Guimi22/DSP-Audio-Amplifier/Defensa/TFG_GuillemRoperoSerrano.pdf

# Disseny i implementació d’un

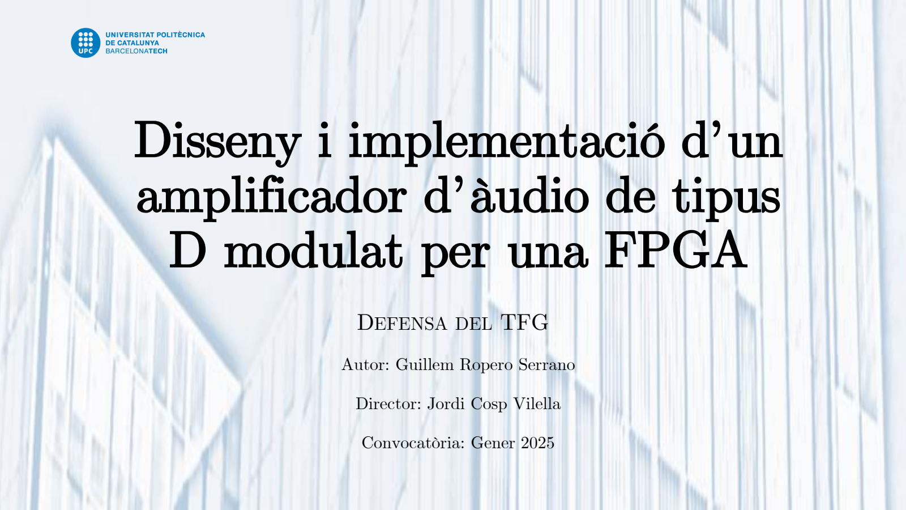
[picture p1: page 1]

# amplificador d’àudio de tipus D modulat per una FPGA

DEFENSA DEL TFG

Director: Jordi Cosp Vilella

Autor: Guillem Ropero Serrano

Convocatòria: Gener 2025

# Introducció

Fig. 1.- Diagrama de blocs d’un amplificador digital de classe D.

# Introducció

Eff. Energ.

≈ 90-80 %

TAS2320 | 93,2 – 80 %
MAX98365 | 92,7 – 84,8 %

Taula 1.- Taula de rendiment energètics d’amplificadors d’àudio de tipus D comercials.

# Introducció

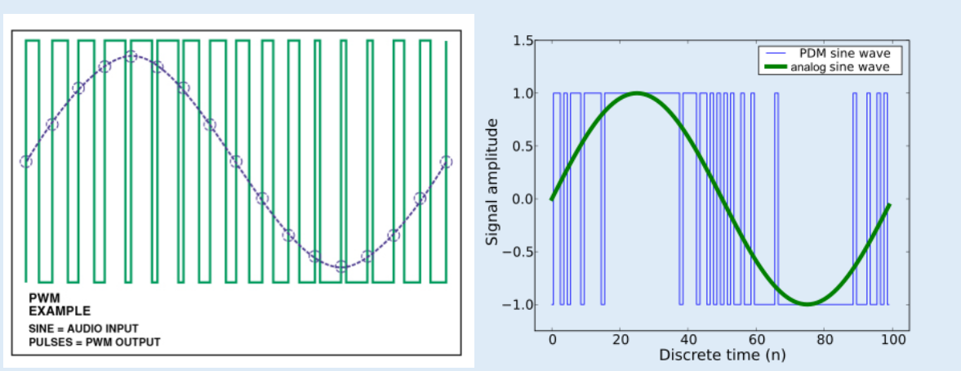
[picture p2: figure]

Fig. 2.- Estratègies de modulació: PWM (dreta) [1], PDM (esquerra) [2].

# Introducció

Fig. 1.- Diagrama de blocs d’un amplificador digital de classe D.

# TFG

# Introducció

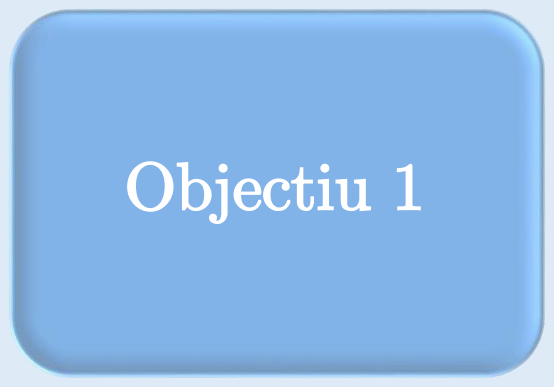
[picture p3: figure]

## Implementar Receptor I2S

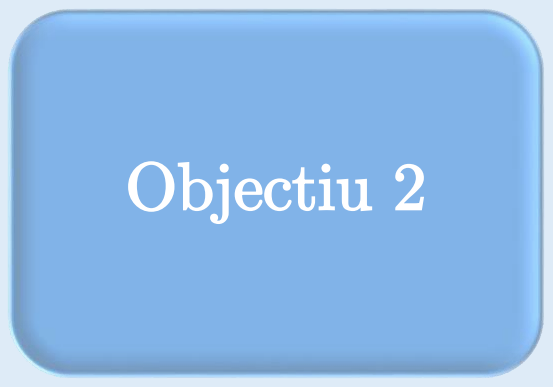
[picture p4: figure]

## D & I Filtre Anti-Aliasing

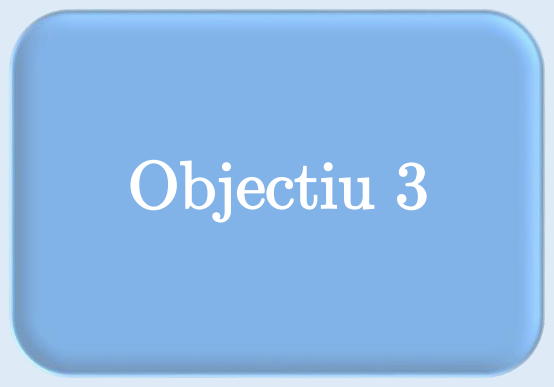
[picture p5: figure]

D & I

## modulador ΣΔ

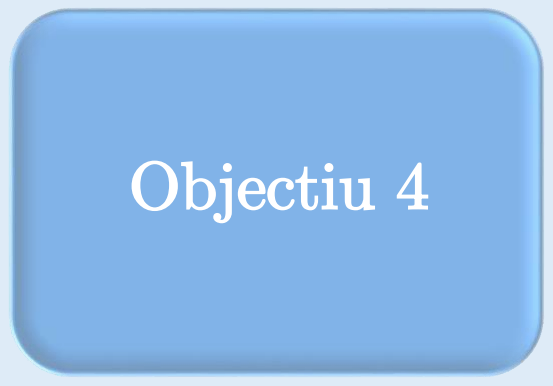
[picture p6: figure]

## D & I Filtre Delmat

Objectiu 1 | Objectiu 2 | Objectiu 3 | Objectiu 4

# Proposta de Resolució

# Diagrama de blocs del sistema

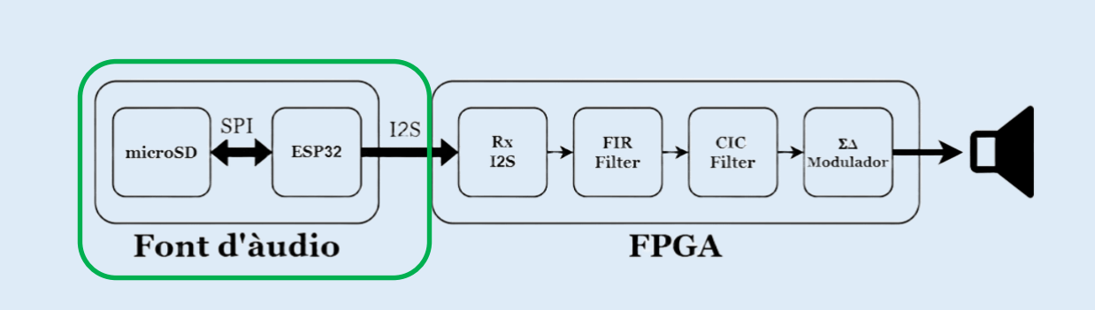
[picture p7: figure]

Fig. 2.- Diagrama de blocs del sistema implementat.

# Font d’Àudio Digital

# Font d’Àudio Digital

# Objectius:

## - Lectura d’arxius .wav - Transmetre mostres d’àudio en protocol I2S - Freqüència de mostreig = 44,1 kHz - Format Philips estàndard

# Font d’Àudio Digital

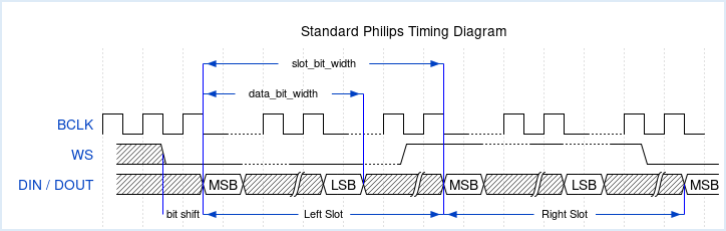
[picture p8: figure]

Fig. 3.- Frame del bus I2S en mode d’operació de l’estàndard Philips. [3]

# Font d’Àudio Digital

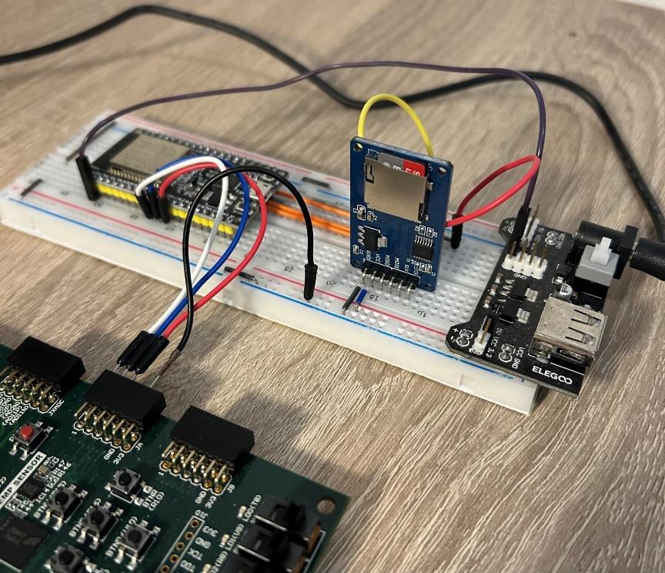
[picture p9: figure]

Fig. 3.- Fotografía de la implementació de la font d’àudio.

# Font d’Àudio Digital

## Què s’ha utilitzat? - Targeta ESP32

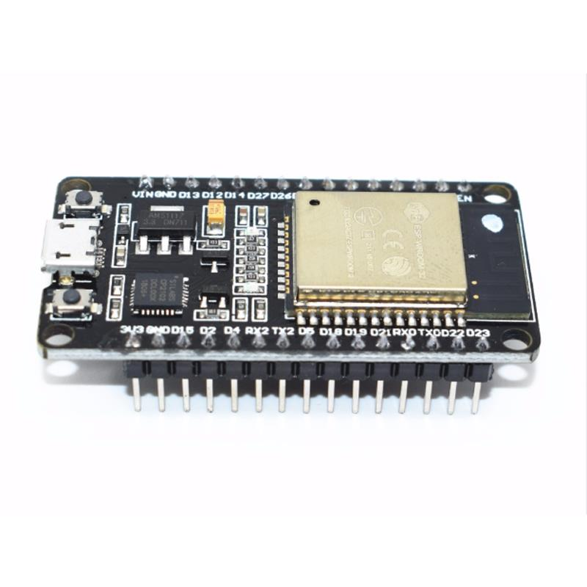
[picture p10: figure]

Fig. 4.- Fotografía d’una
targeta ESP32 WROOM.
[4]

# Font d’Àudio Digital

## Què s’ha utilitzat? - Mòdul adaptador targeta microSD

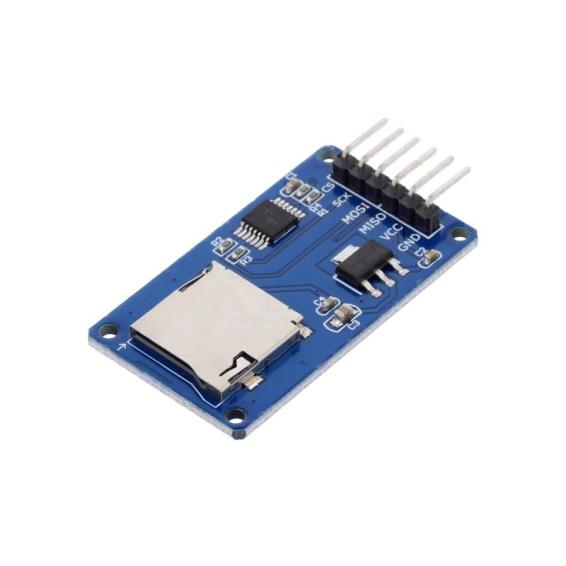
[picture p11: figure]

Fig. 5.- Fotografía del
mòdul adaptador d’una
targeta microSD. [4]

# Font d’Àudio Digital

## Què s’ha utilitzat? - Targeta microSD

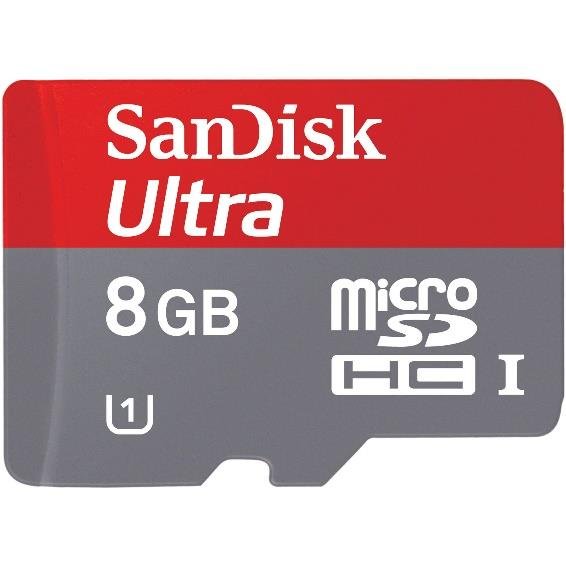
[picture p12: figure]

Fig. 6.- Fotografía de
la targeta microSD
utilitzada per
emmagatzemar
l’arxiu .wav . [5]

# Font d’Àudio Digital

## Què s’ha utilitzat? - Mòdul alimentació 5V i

3,3V

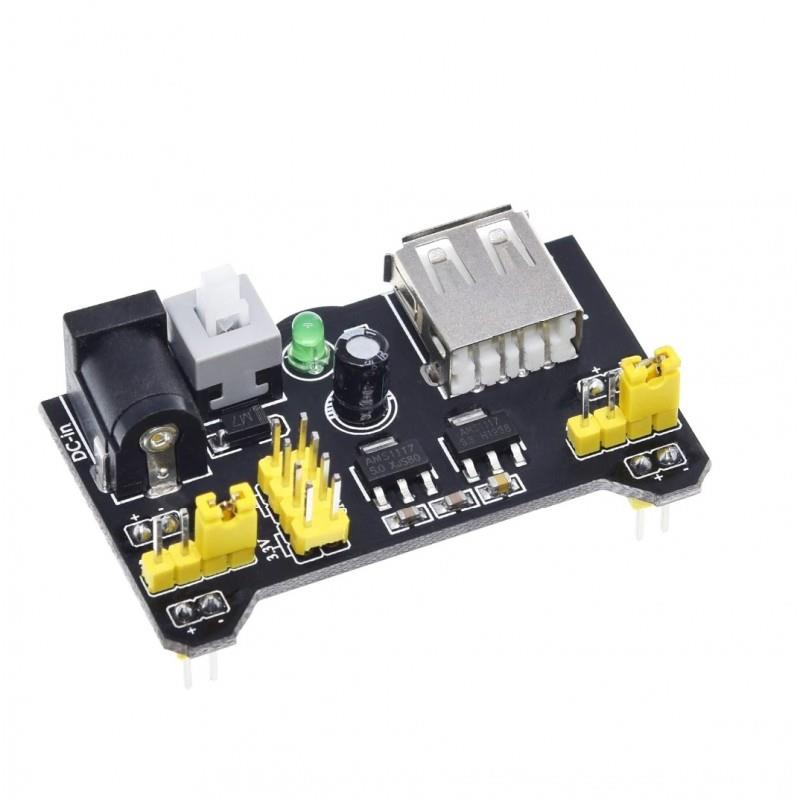
[picture p13: figure]

Fig. 7.- Fotografía d’un
mòdul d’alimentació 5V
i de 3,3V. [4]

# Font d’Àudio Digital

# Funcionalitats del codi

## - Lectura de l’arxiu emmagatzemat a la targeta microSD - Transmetre les mostres d’àudio pel bus I2S

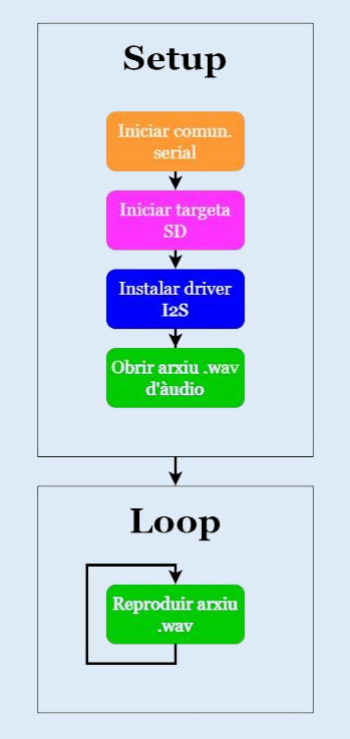
[picture p14: figure]

Fig. 8.- Diagrama de flux
del codi implementat pel
funcionament de la font
d’àudio.

# Diagrama de blocs del sistema

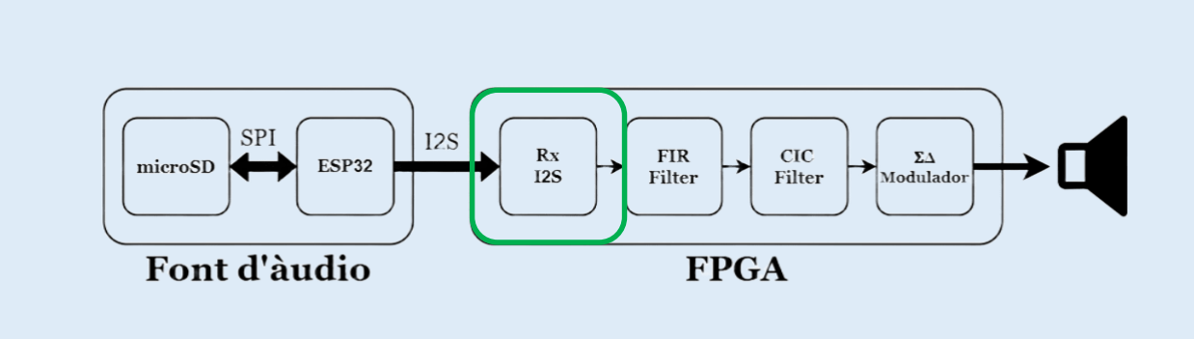
[picture p15: figure]

Fig. 2.- Diagrama de blocs del sistema implementat.

# Receptor I2S

# Receptor I2S

# Objectius:

## - Lectura bus I2S en format Philips estàndard - Capturar mostres d’àudio enviades pel bus I2S - Amplada mostres d’àudio de 16 bits - Sortida àudio mono

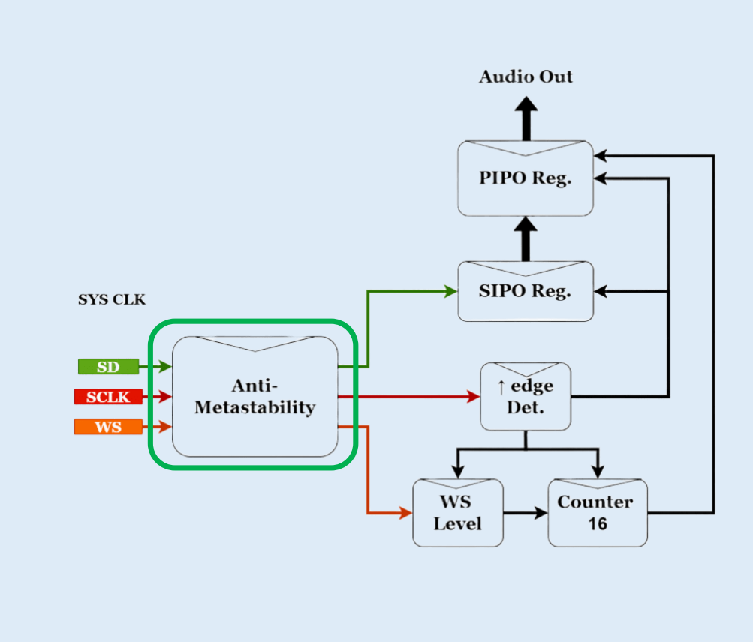
[picture p16: figure]

Fig. 9.

- Diagrama de
blocs de l’entitat
dissenyada en VHDL.

# Receptor I2S

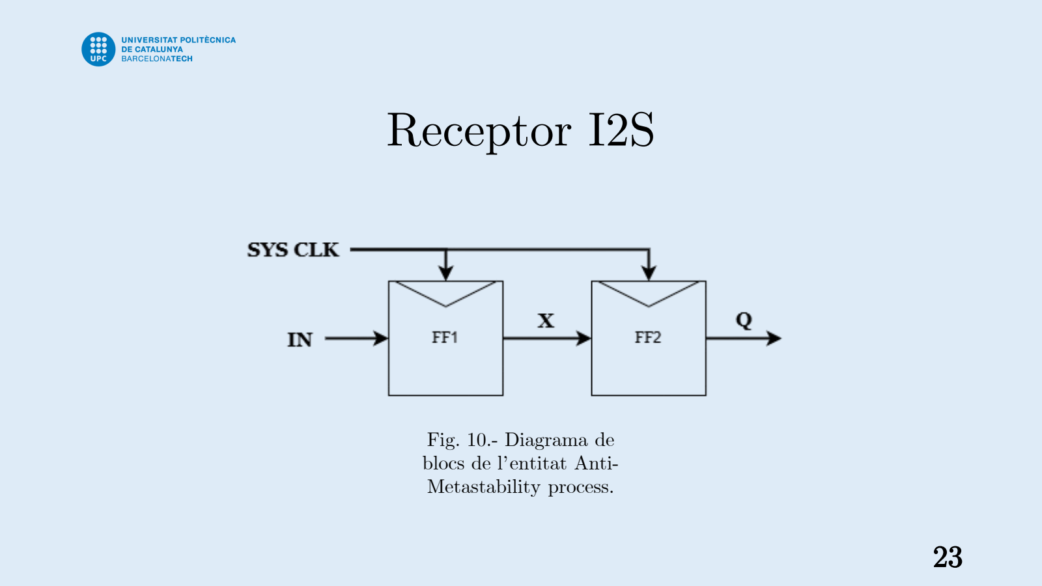
[picture p17: page 23]

Fig. 10.- Diagrama de
blocs de l’entitat Anti-Metastability process.

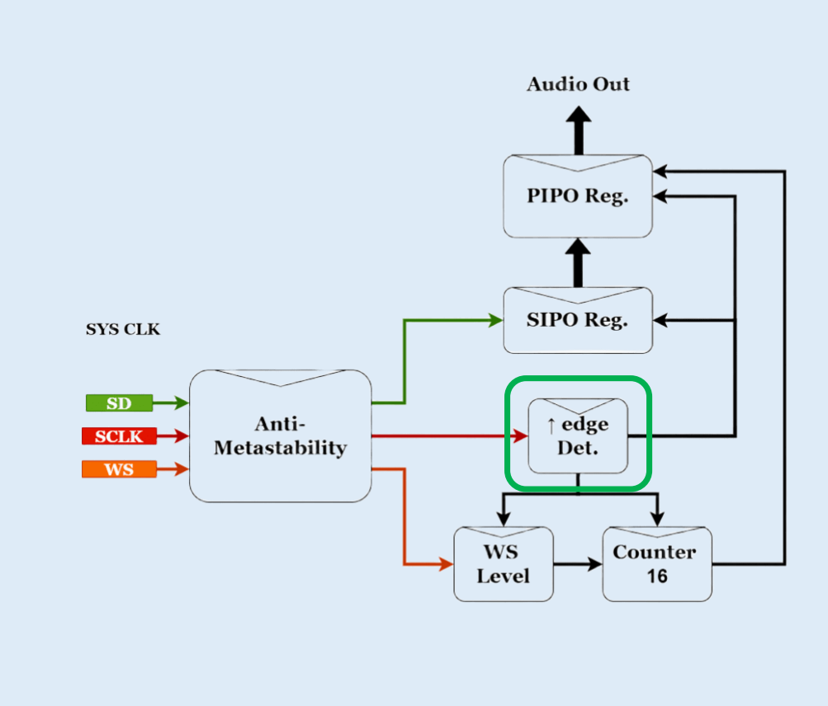
[picture p18: figure]

Fig. 9.

- Diagrama de
blocs de l’entitat
dissenyada en VHDL.

# Receptor I2S

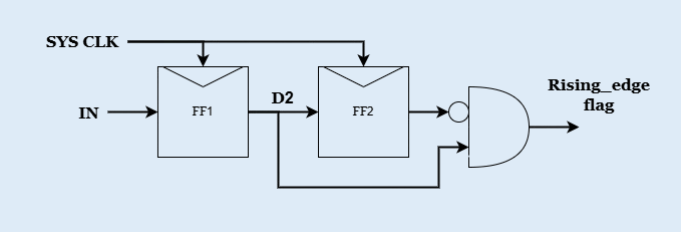
[picture p19: figure]

Fig. 11.- Diagrama de blocs de l’entitat Rising edge Detection.

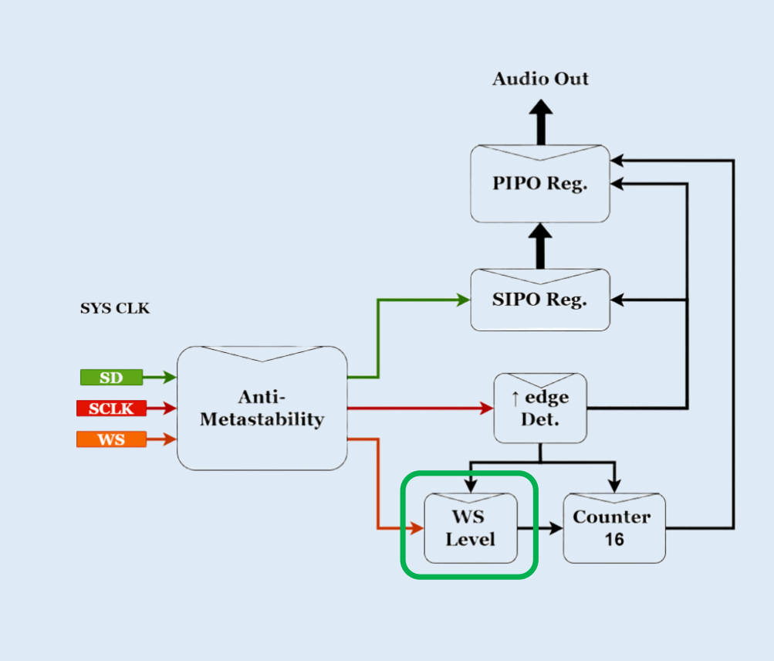
[picture p20: figure]

Fig. 9.

- Diagrama de
blocs de l’entitat
dissenyada en VHDL.

# Receptor I2S

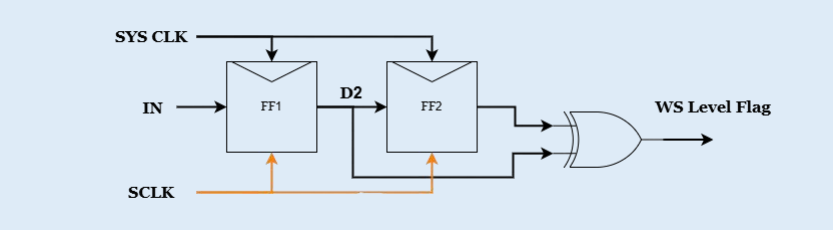
[picture p21: figure]

Fig. 12.- Diagrama de blocs de l’entitat WS Level Detection.

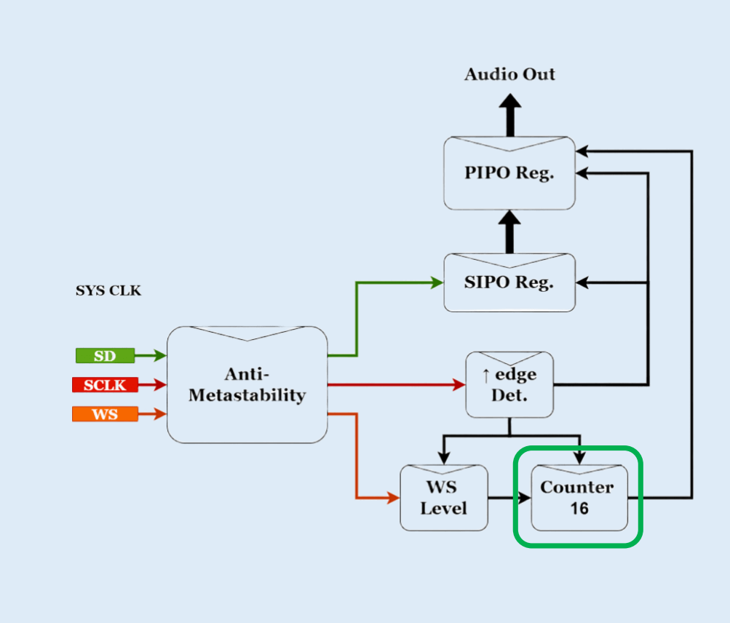
[picture p22: figure]

Fig. 9.

- Diagrama de
blocs de l’entitat
dissenyada en VHDL.

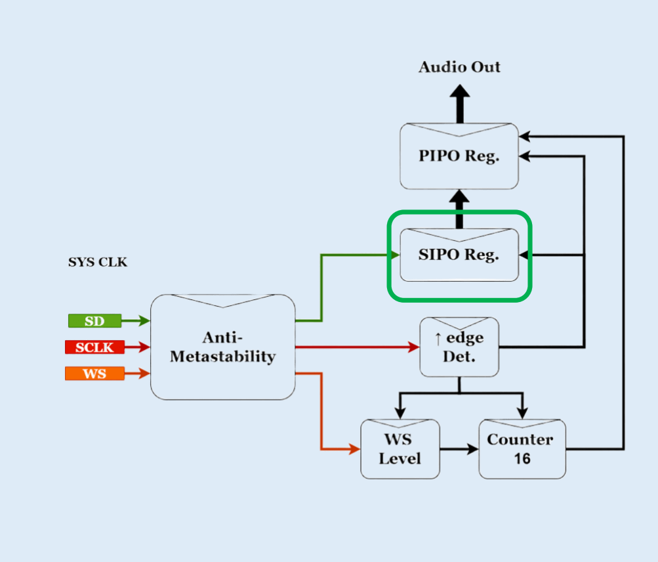
[picture p23: figure]

Fig. 9.

- Diagrama de
blocs de l’entitat
dissenyada en VHDL.

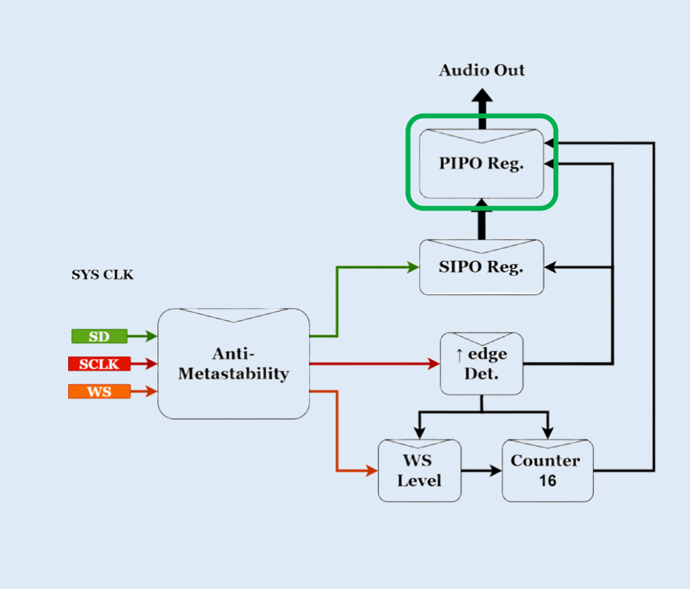
[picture p24: figure]

Fig. 9.

- Diagrama de
blocs de l’entitat
dissenyada en VHDL.

# Diagrama de blocs del sistema

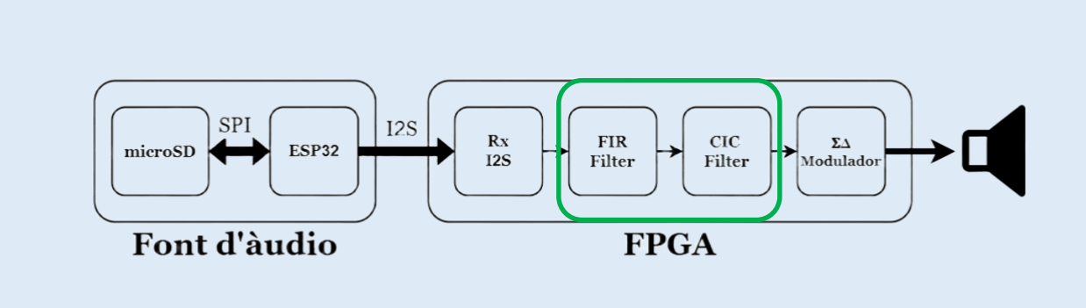
[picture p25: figure]

Fig. 2.- Diagrama de blocs del sistema implementat.

# Filtre Anti-Aliasing

# Filtre Anti-Aliasing

# Objectius:

## - Sobremostrejar el senyal d’entrada a x32 de la freqüència de mostreig i

interpolar.

## - Atenuar components harmònics fora de l’espectre

d’interés (20 a 20000 Hz).

# Filtre Anti-Aliasing

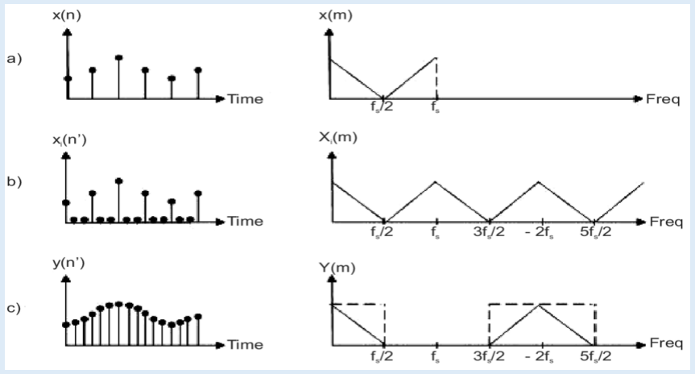
[picture p26: figure]

Fig. 13.- Procés d’interpolació d’un senyal en temps discret. [6]

# Filtre Anti-Aliasing

## L’etapa de filtrat es divideix en dues etapes: - Filtre de compensació - Filtre CIC

# Filtre Anti-Aliasing

## Filtre de compensació

Factor d’interpolació | 2
Freqüència de pas | 20 kHz
Freqüència de tall | 22,05 kHz
Atenuació a la banda de tall | 80 dB
Freqüència de mostreig | 44,1 kHz

Taula 2.- Especificacions del filtre de compensació de l’etapa d’Interpolació.

# Filtre Anti-Aliasing

## Filtre de compensació

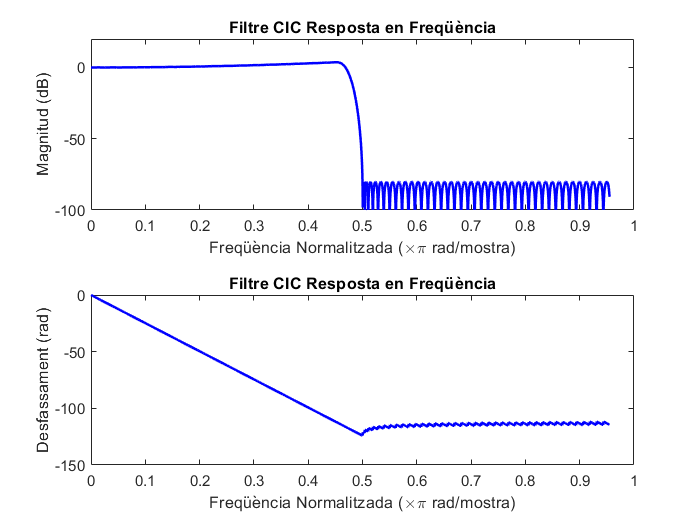
[picture p27: figure]

Fig. 14.- Diagrama de
Bode de l’etapa de filtrat i compensació de la resposta en freqüència de
l’interpolador CIC.

# Filtre Anti-Aliasing

## Filtre de compensació Implementació a la FPGA: - Mòdul IP FIR Compiler

Nom del Paràmetre | Valor
Tipus de Filtre | Interpolació
Taxa d’Interpolació | 2
Freqüència de mostreig d’entrada | 44,1 kHz
Freqüència del rellotge | 100 MHz
Tipus de coeficients | Amb signe
Amplada de coeficients | 153
Tipus de dades d’entrada | Amb signe
Amplada de les dades d’entrada | 16
Mode d’arrodoniment a la sortida | Truncar els LSBs
Amplada de dades a la sortida | 16

Taula 3.- Configuracions dels paràmetres del mòdul IP FIR Compiler.

# Filtre Anti-Aliasing

## Filtre CIC

y | n | =

σk=0

## M−1 x[n − k]

M

y | n | =
y | n − 1 | + x | n | − x[n − M]
| | | M

Filtre de Mitjana Mòbil:

Filtre CIC:

# Filtre Anti-Aliasing

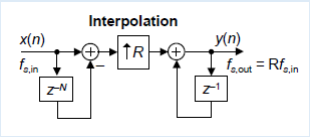
[picture p28: figure]

Fig. 15.- Estructura d’un filtre CIC Interpolador. [7]

## Filtre CIC

# Filtre Anti-Aliasing

Factor d’interpolació (R) | 16
Delay diferencial (M) | 1
Ordre del filtre (N) | 5

Taula 4.- Especificacions del filtre CIC.

## Filtre CIC

# Filtre Anti-Aliasing

## Filtre CIC

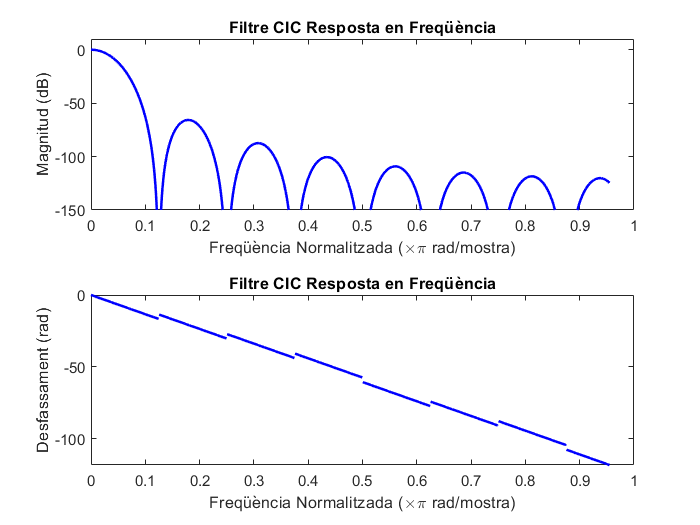
[picture p29: figure]

Fig. 16.- Diagrama de
Bode de l’etapa de
l’interpolador CIC.

# Filtre Anti-Aliasing

## Filtre CIC Implementació a la FPGA: - Mòdul IP CIC Compiler

Nom del Paràmetre | Valor
Tipus de Filtre | Interpolació
Taxa d’Interpolació | 16
Freqüència de mostreig d’entrada | 88,2 kHz
Freqüència del rellotge | 100 MHz
Amplada de les dades d’entrada | 16
Quantificació | Truncament
Amplada de dades a la sortida | 16

Taula 5.- Configuracions dels paràmetres del mòdul IP CIC Compiler.

# Filtre Anti-Aliasing

## Resultats Etapa de filtrat

Taula 6.- Especificacions de l’etapa de filtrat anti-aliasing.

Oscil·lació máxima en la banda de pas | 1,49 dB
Freqüència de tall | 20460 Hz
Atenuació en la banda de tall | -53 dB

# Filtre Anti-Aliasing

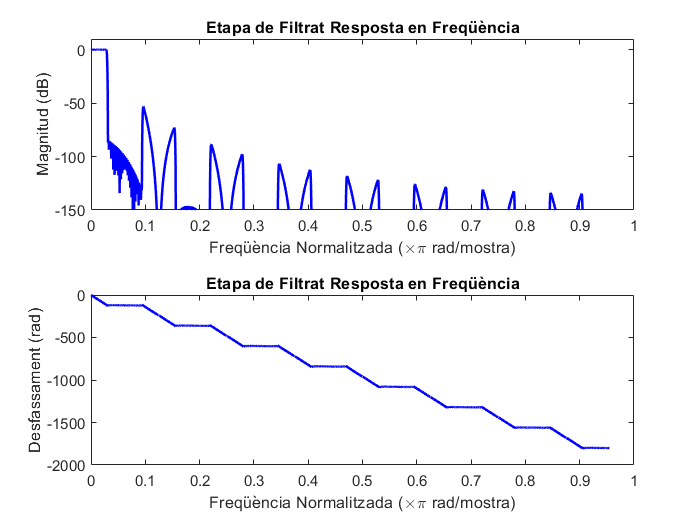
[picture p30: figure]
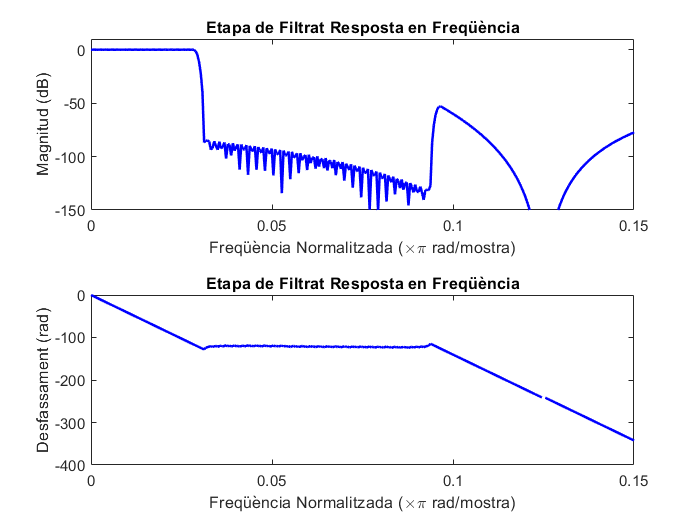
[picture p31: figure]

Fig. 17.- Diagrama de Bode de l’etapa de filtrat anti-aliasing.

## Resultats Etapa de filtrat

# Diagrama de blocs del sistema

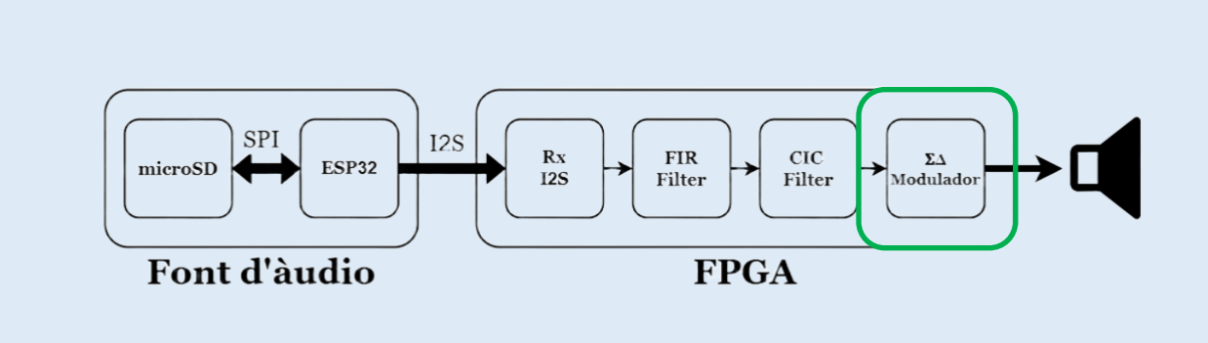
[picture p32: figure]

Fig. 2.- Diagrama de blocs del sistema implementat.

# Modulador ΣΔ

# Modulador ΣΔ

# Objectius:

## - Desplaçar soroll produit pel procés de quantificació a freqüències > freqüència de

mostreig.

## - Atenuar components harmònics del senyal fora de

la banda de mostreig.

# Modulador ΣΔ

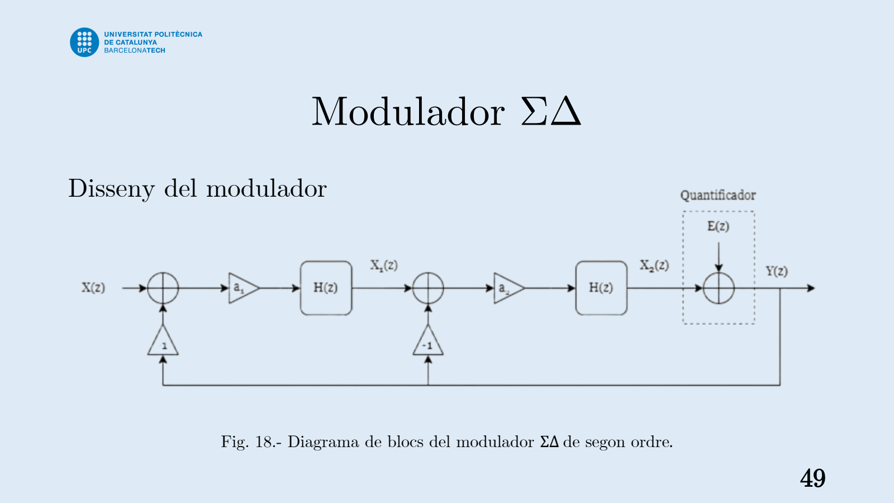
[picture p33: page 49]

## Disseny del modulador

Fig. 18.- Diagrama de blocs del modulador ΣΔ de segon ordre.

# Modulador ΣΔ

## Disseny del modulador

a1 = a2 = 0,5 H z =

z

−1
1 − z

−1

STF z =

z

−2
3z

−2 − 6z

−1 + 4

NTF z =

(1 − z

−1
)

2
3z

−2 − 6z

−1 + 4

# Modulador ΣΔ

## Disseny del modulador

Fig. 19.- Cercle unitari en el pla polar de STF i

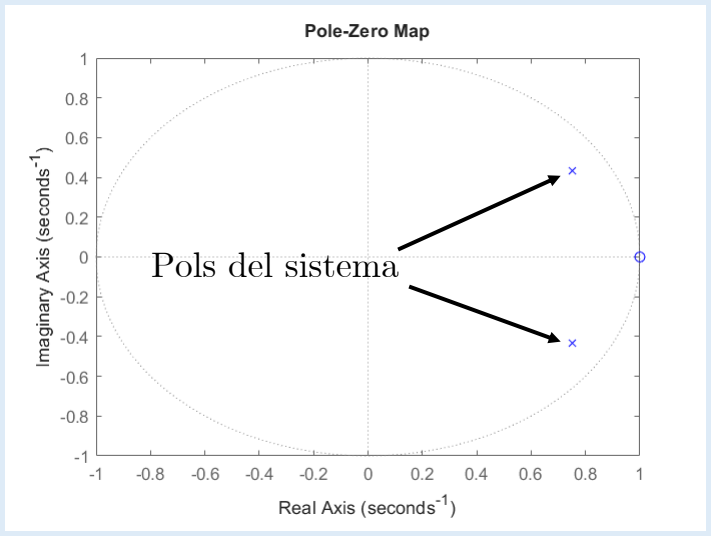
[picture p34: figure]

NTF. | Pols del sistema

# Modulador ΣΔ

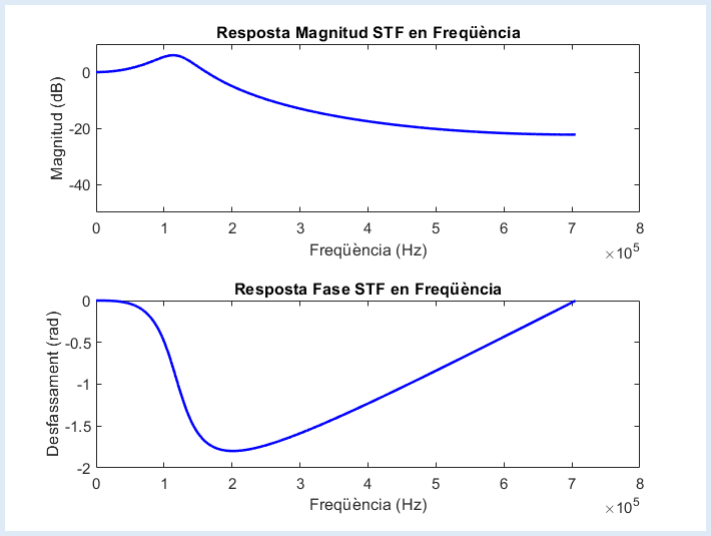
[picture p35: figure]

## Disseny del modulador

Fig. 20.- Diagrama de
Bode de la funció de
transferència del senyal
(STF).

# Modulador ΣΔ

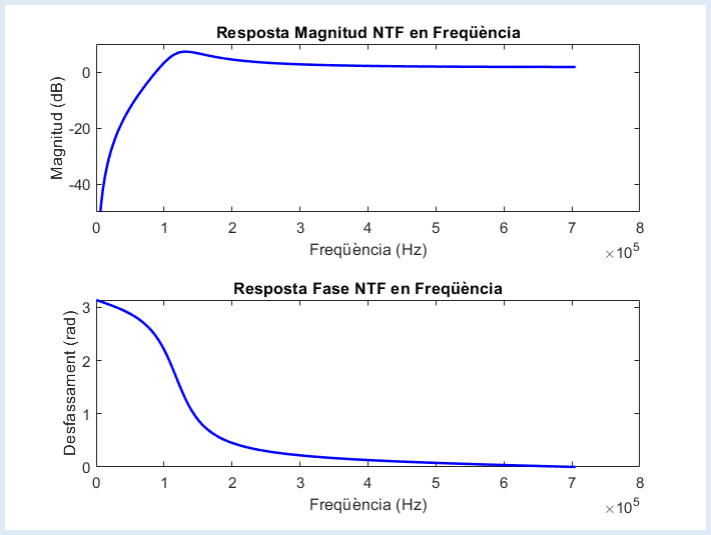
[picture p36: figure]

## Disseny del modulador

Fig. 21.- Diagrama de
Bode de la funció de
transferència del soroll
(NTF).

# Modulador ΣΔ

## Disseny del modulador

SQNR | 70,1 dB
DR | 112,28 dB
OSR | 32
Freqüència de mostreig | 1,41 MHz
Freqüència de tall de la STF | 183,6 kHz
Freqüència de tall de la NTF | 77,95 kHz
Freqüència de pic de la STF i NTF | 117,46 kHz

Taula 7.- Taula de les
mètriques de rendiment
calculades pel modulador
ΣΔ.

# Modulador ΣΔ

## Implementació a la FPGA

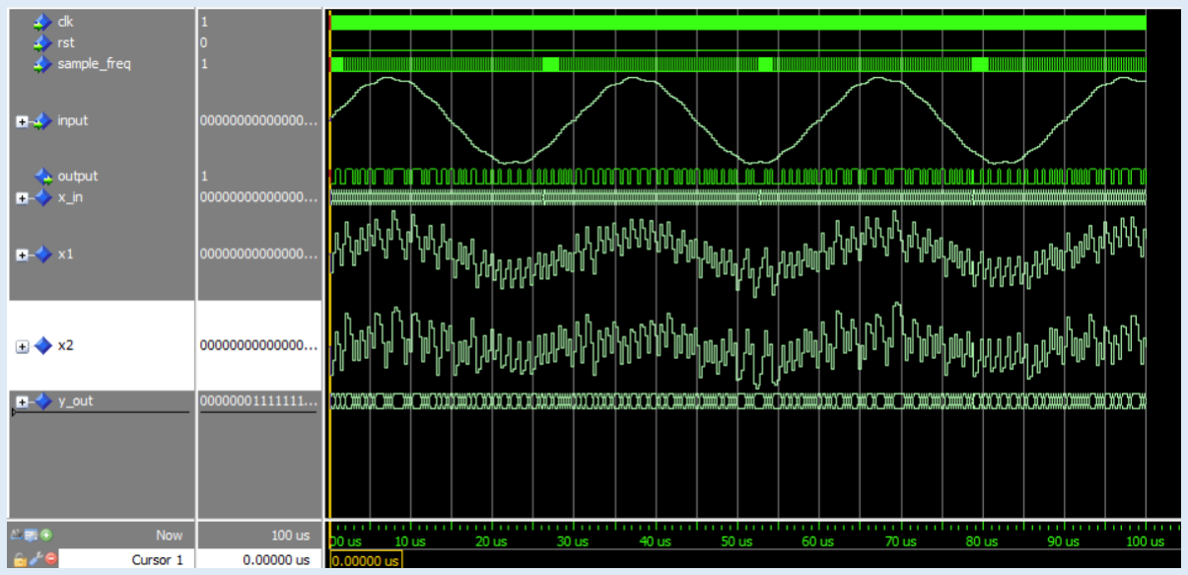
[picture p37: figure]

Fig. 22.- Cronograma del
banc de proves del
modulador ΣΔ.

# Modulador ΣΔ

## Implementació a la FPGA

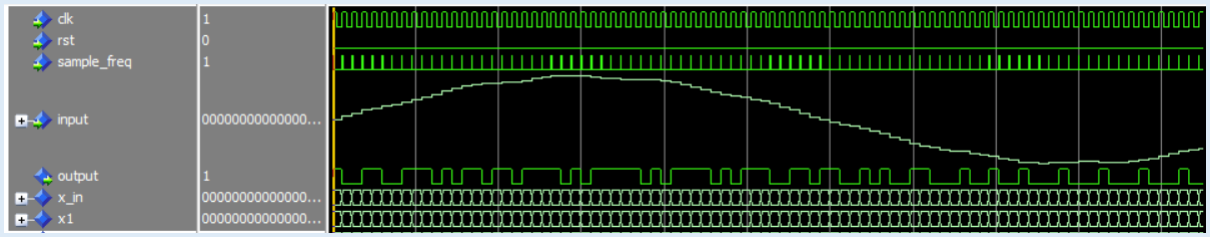
[picture p38: figure]

Fig. 23.- Cronograma del banc de proves del modulador ΣΔ.

# Implementació final

Recurs | Nombre
LUTs | 1170
Registres | 891
Slices | 247
Muxes | 46
DSPs | 4

# Implementació final

Taula 8.- Utilització
de recursos de la
FPGA en la
implementació final
del projecte.

# Projecte sintetitzat a la FPGA

# Implementació final

# Resultat final

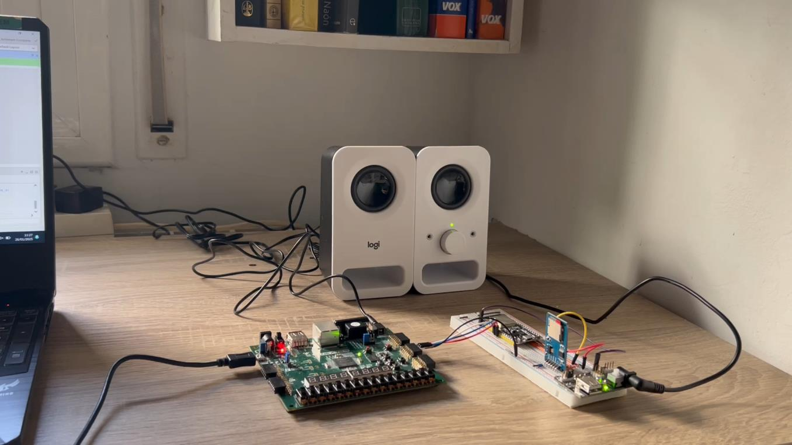
[picture p39: figure]

# Implementació final

# Conclusions

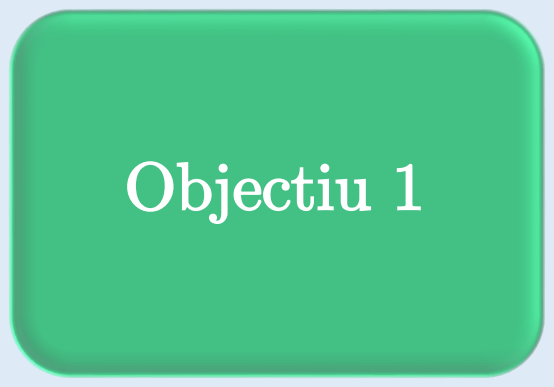
[picture p40: figure]

## Implementar Receptor I2S

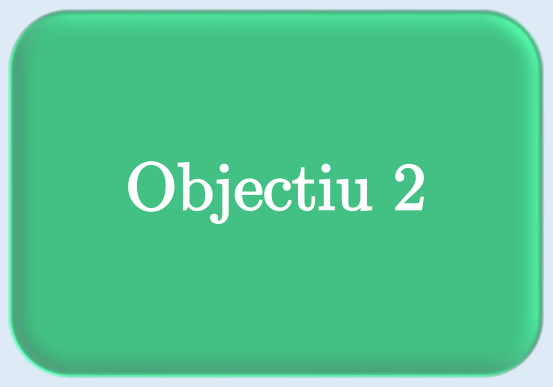
[picture p41: figure]

## D & I Filtre Anti-Aliasing

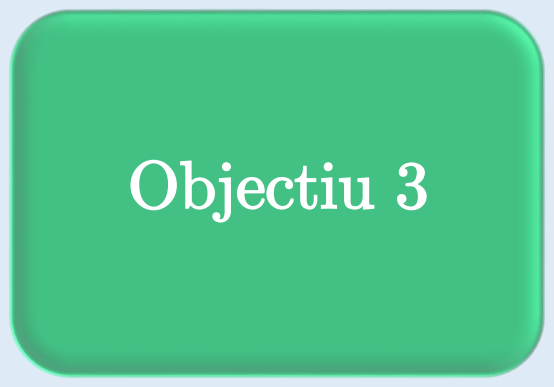
[picture p42: figure]

D & I

## modulador ΣΔ

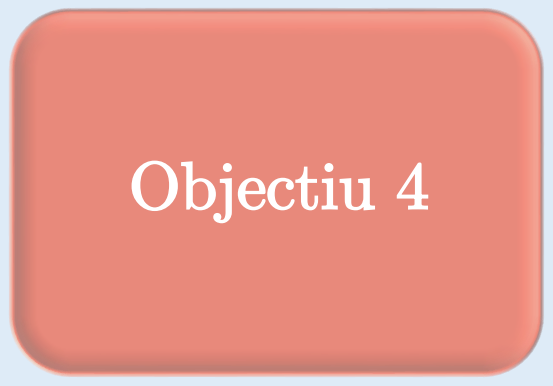
[picture p43: figure]

## D & I Filtre Delmat

Objectiu 1 | Objectiu 2 | Objectiu 3 | Objectiu 4

# Implementació final

- Disseny & Implementació d’una etapa de delmat.
- Disseny d’un modulador ΣΔ de major ordre.

## - Disseny & Implementació d’una etapa d’amplificació amb

transistors GaN FET.

# Futures línies de treball

# Bibliografía

[1] E. Gaalaas,

“Class D Audio amplifiers: What, why, and how”, Analog Devices. https://www.analog.com/en/resources/analog-dialogue/articles/class-d-audio-amplifiers.html

[2] Wikipedia contributors, “Pulse-density modulation”, Wikipedia, Feb. 14, 2024. https://en.wikipedia.org/wiki/Pulse-density_modulation
[3] E. Systems, “Inter-ic sound (i2s)- esp32- esp-idf programming guide v5.4 documentation.” https://docs.espressif.com/projects/esp-idf/en/stable/esp32/api-reference/peripherals-/i2s.html, accedit el Gener 2025.
[4] Diotronic, “Diotronic S.A. – Componentes electrònicos” https://diotronic.com/, accedit el Gener 2025.

# Bibliografía

[5] eBay, “8G SanDisk Micro SD TF Memory Card 8GB Flash Memory Card Mini SDHC SDXC Adapter” https://www.ebay.ca/itm/8G-SanDisk-Micro-SD-TF-Memory-Card-8GB-Flash-Memory-Card-Mini-SDHC-SDXC-Adapter/224081107877, accedit el Gener 2025.
[6] F. Rubén, I. A. Badillo, G. F. Torres, and J. S. García, “Simplification to the fast FIR-FFT filtering technique in the DSP interpolation process for band-limited signals” Revista Facultad de Ingeniería Universidad de Antioquia, no. 68, pp. 9–19, Oct. 2013, doi: https://doi.org/10.17533/udea.redin.17036.
[7] R. Lyons, “A beginner’s guide to cascaded integrator-comb (cic) filters.” https: //www.dsprelated.com/showarticle/1337.php, accedit el Gener 2025.

# Gràcies per la vostra atenció
