Guimi22/DSP-Audio-Amplifier/Defensa/Imatges/codi_counter2.png

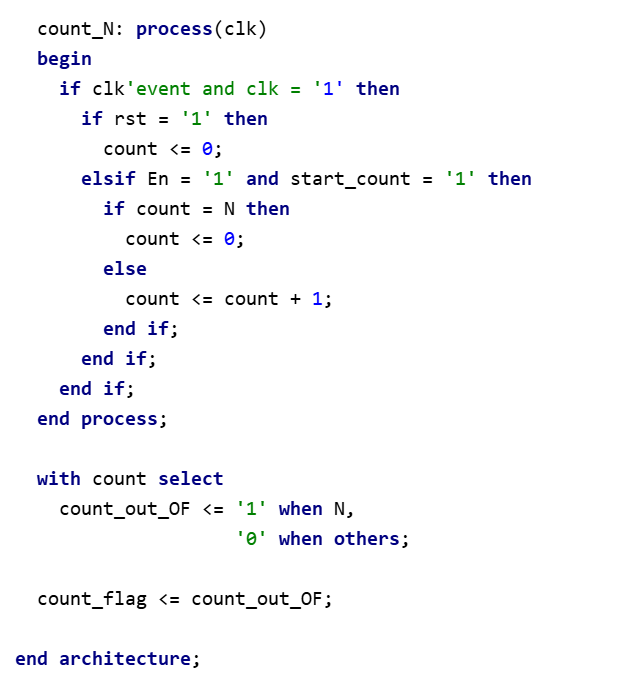
Defensa/Imatges/codi_counter2.png
