Guimi22/DSP-Audio-Amplifier/Defensa/Imatges/codi_counter.png

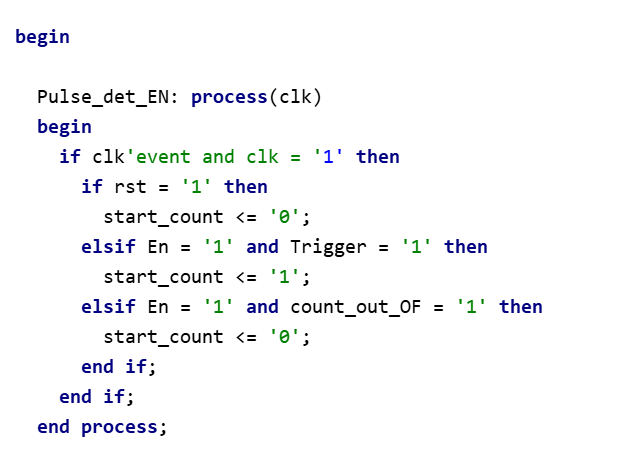
Defensa/Imatges/codi_counter.png
