Guimi22/DSP-Audio-Amplifier/Defensa/Imatges/codi_filtrecompCIC.png

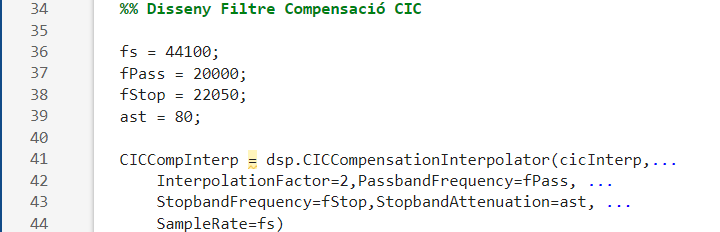
Defensa/Imatges/codi_filtrecompCIC.png
