Guimi22/DSP-Audio-Amplifier/Defensa/Imatges/codi_PIPO.png

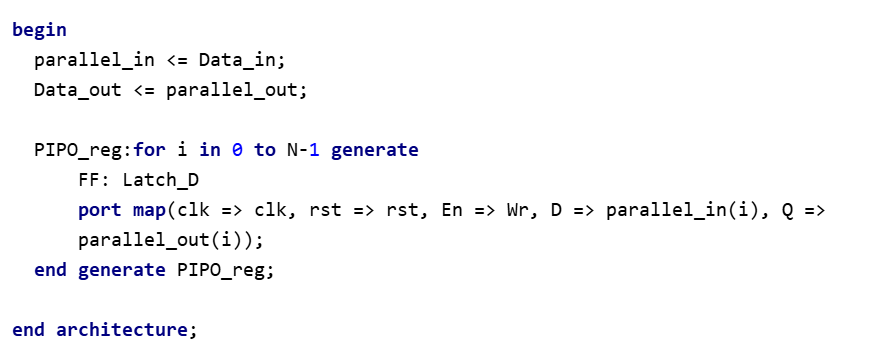
Defensa/Imatges/codi_PIPO.png
