Guimi22/DSP-Audio-Amplifier/Defensa/Imatges/codi_Risng_edge_det.png

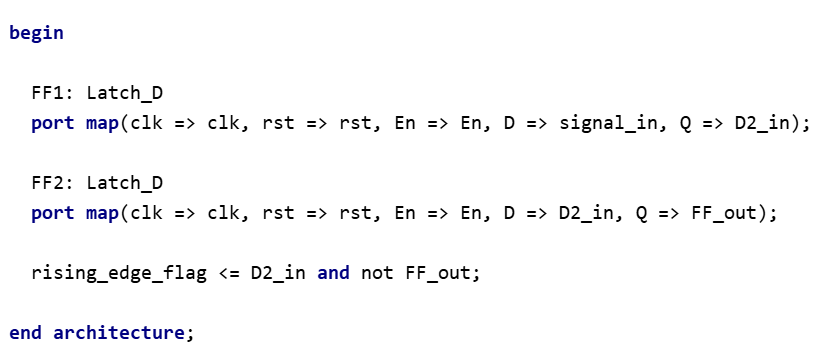
Defensa/Imatges/codi_Risng_edge_det.png
