Guimi22/DSP-Audio-Amplifier/Defensa/Imatges/codi_SD.png

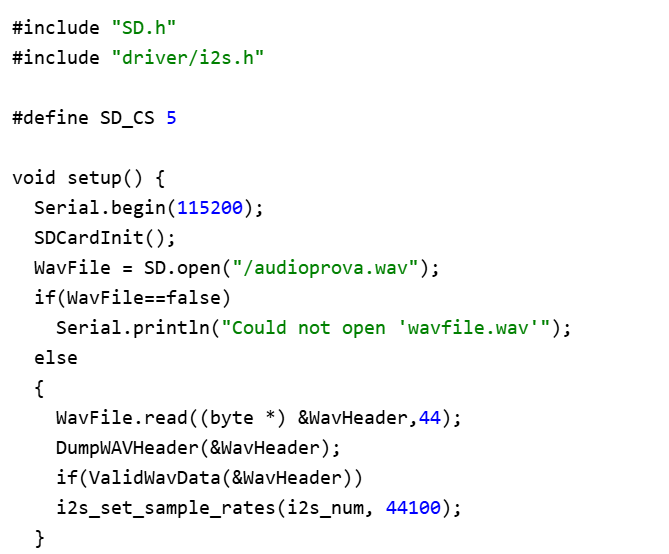
Defensa/Imatges/codi_SD.png
