Guimi22/DSP-Audio-Amplifier/Defensa/Imatges/codi_SIPO.png

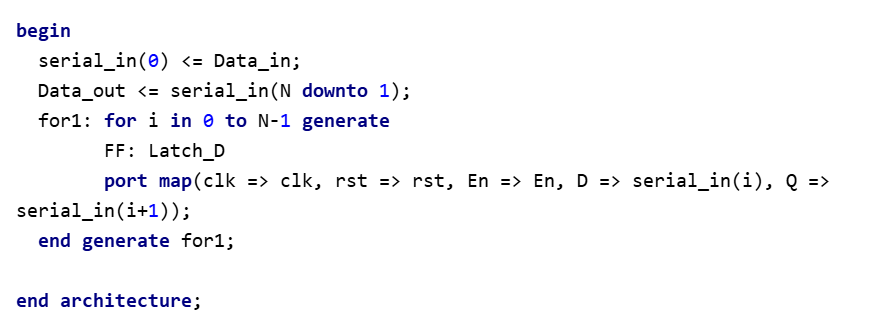
Defensa/Imatges/codi_SIPO.png
