Guimi22/DSP-Audio-Amplifier/Defensa/Imatges/codi_top2.png

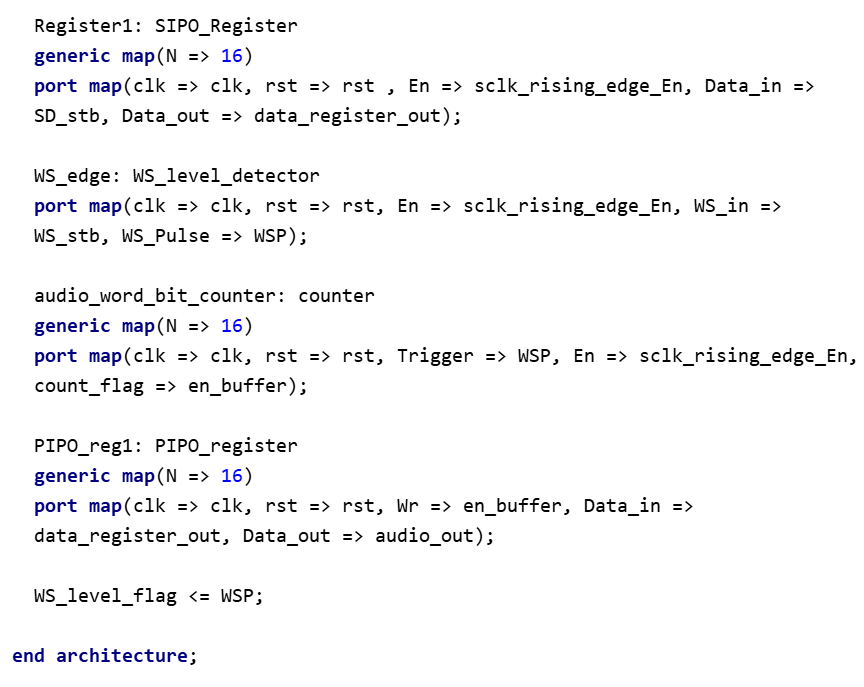
Defensa/Imatges/codi_top2.png
