Guimi22/DSP-Audio-Amplifier/Defensa/Imatges/codi_top.png

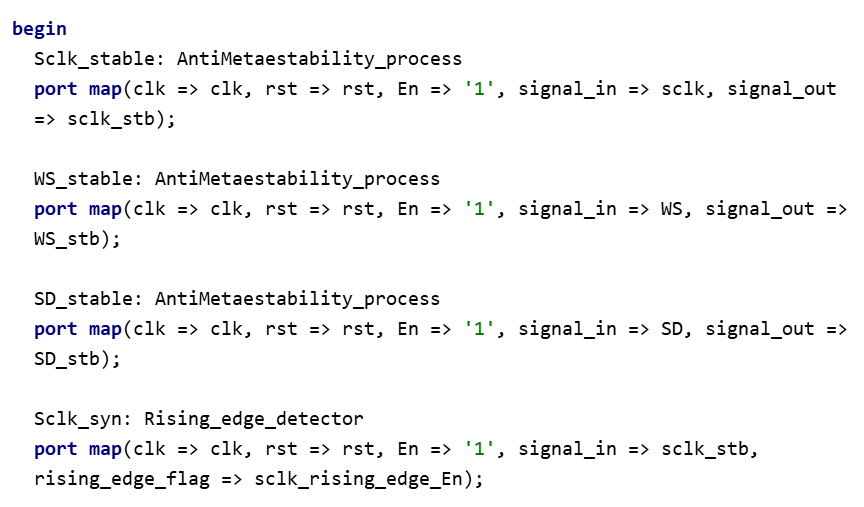
Defensa/Imatges/codi_top.png
