Guimi22/DSP-Audio-Amplifier/Defensa/Imatges/codi_WSP.png

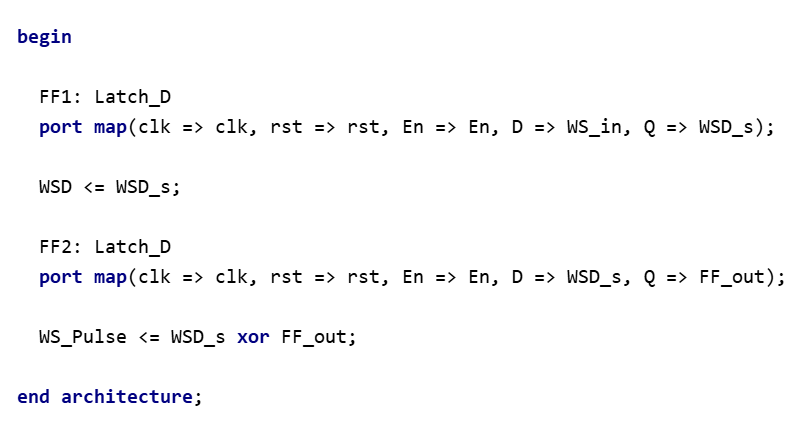
Defensa/Imatges/codi_WSP.png
