Guimi22/DSP-Audio-Amplifier/Defensa/Imatges/Diagrama de blocs sistema.png

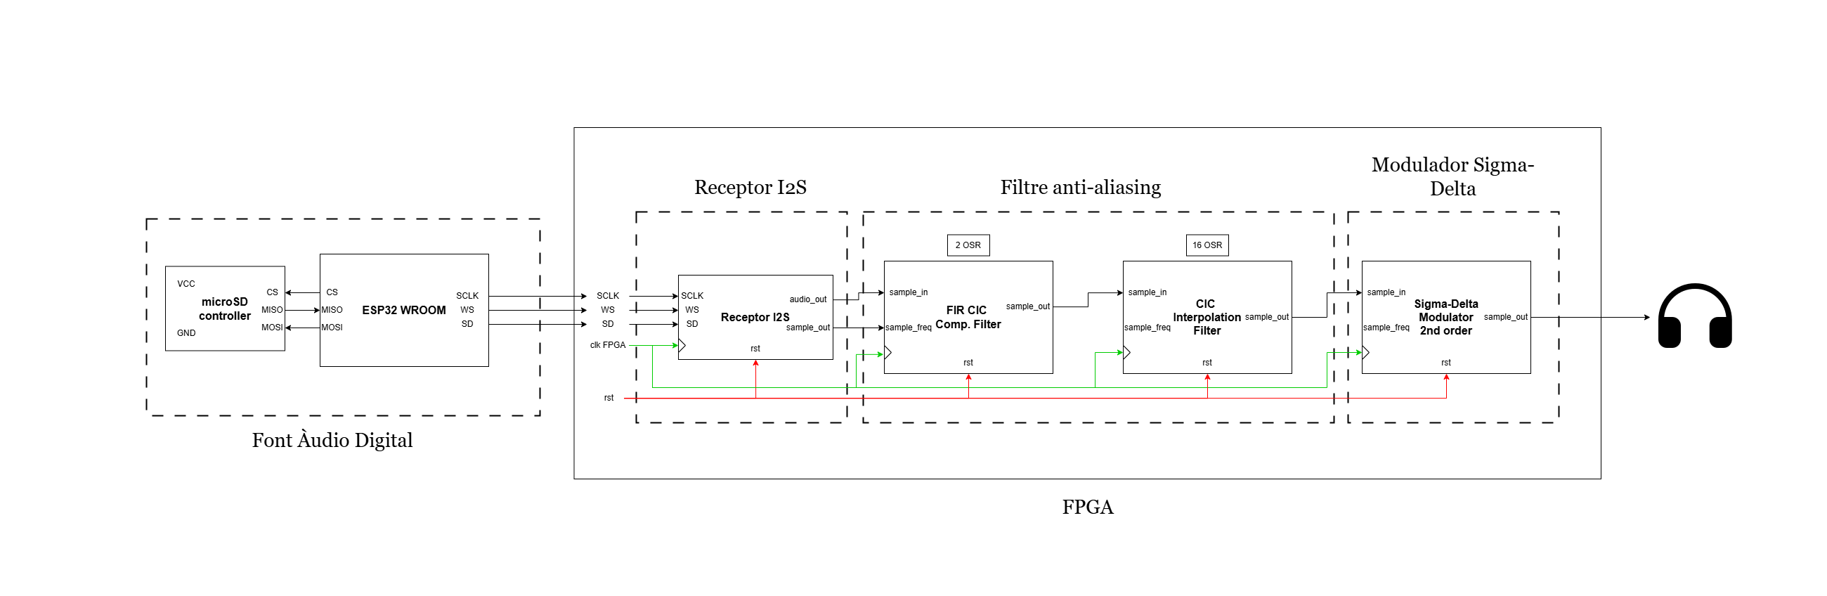
Defensa/Imatges/Diagrama de blocs sistema.png
