Guimi22/DSP-Audio-Amplifier/Defensa/Imatges/DiagramaTransceiverI2S.png

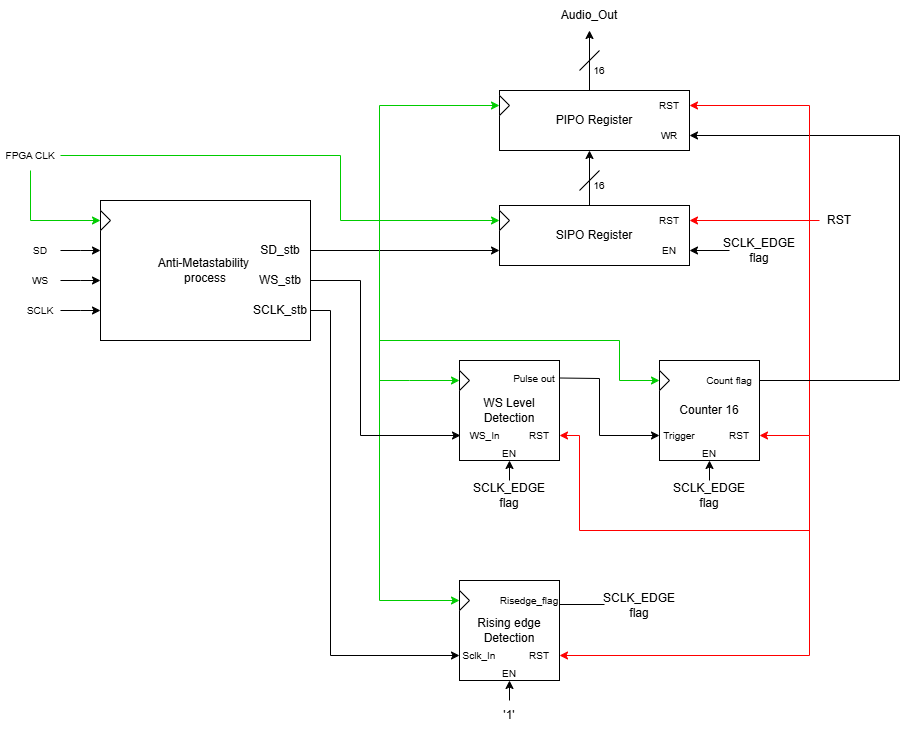
Defensa/Imatges/DiagramaTransceiverI2S.png
