Guimi22/DSP-Audio-Amplifier/Defensa/Imatges/i2s_pin_config.png

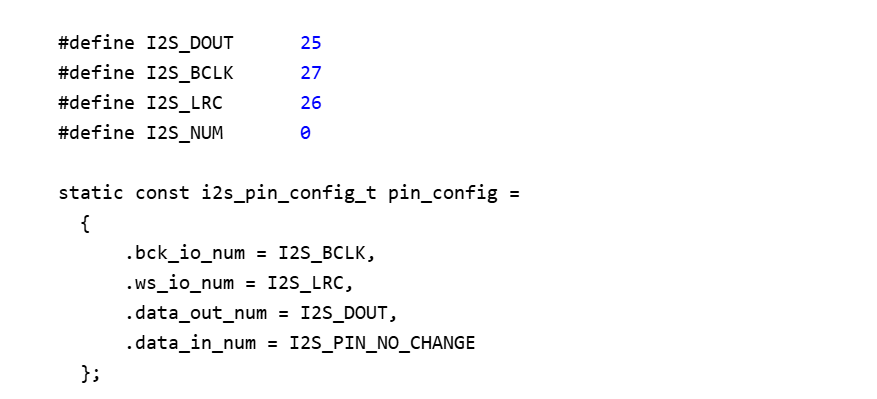
Defensa/Imatges/i2s_pin_config.png
