Guimi22/DSP-Audio-Amplifier/Defensa/Imatges/Pulse_density_modulation.png

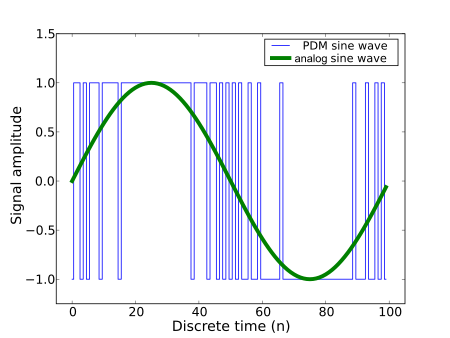
Defensa/Imatges/Pulse_density_modulation.png
