Guimi22/DSP-Audio-Amplifier/Defensa/Imatges/RxI2S.png

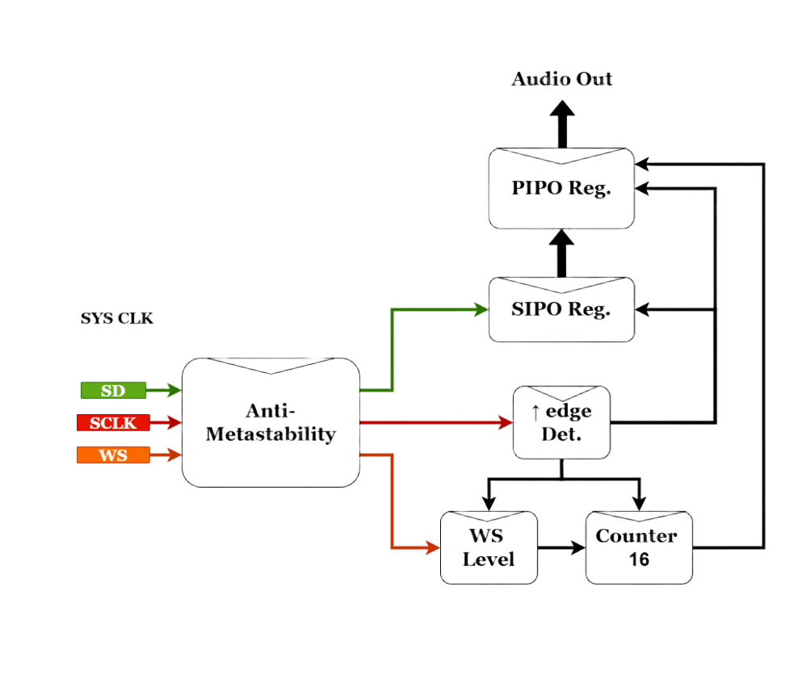
Defensa/Imatges/RxI2S.png
