Guimi22/DSP-Audio-Amplifier/Defensa/Imatges/SigmaDelta.png

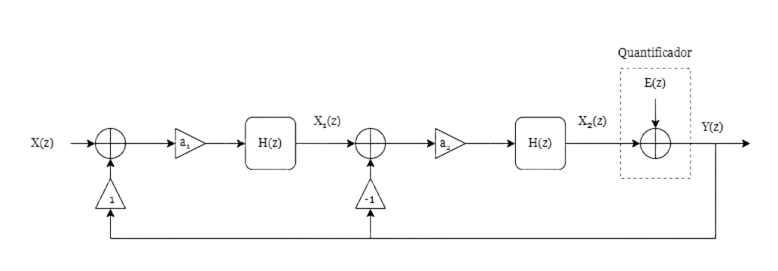
Defensa/Imatges/SigmaDelta.png
