Guimi22/DSP-Audio-Amplifier/Defensa/Imatges/void_loop.png

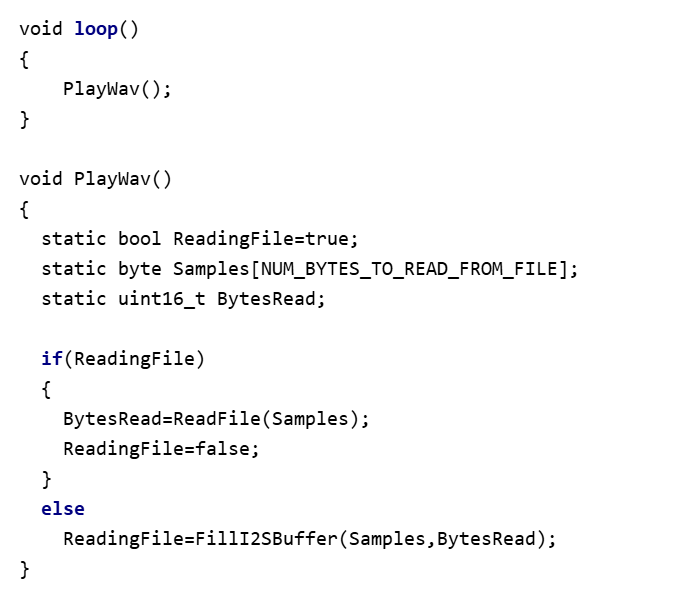
Defensa/Imatges/void_loop.png
