Guimi22/DSP-Audio-Amplifier/Memoria/Images/i2s_mode.png

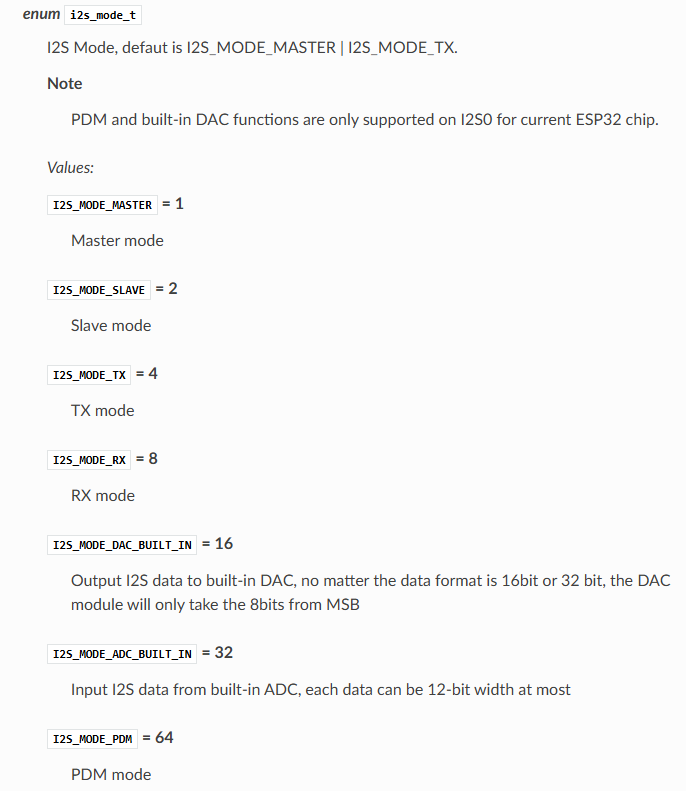
Memoria/Images/i2s_mode.png
