Guimi22/DSP-Audio-Amplifier/Memoria/Parts/agraiments.tex

\chapter*{Agraïments}
\par A la meva familia pel suport incondicional durant la realització d'aquest treball. Al tutor d'aquest treball, Jordi Cosp, pel seu suport tècnic i a l'associcació d'e-Tech Racing i els seus membres, amb qui he passat els millors moments d'aquesta carrera. 

\addcontentsline{toc}{chapter}{\protect\numberline{}Agraïments}
