Guimi22/DSP-Audio-Amplifier/Memoria/Parts/Bibliografia.tex

\chapter{Bibliografia}
\bibliographystyle{ieeetr}
\bibliography{export}
%\printbibliography
