Guimi22/DSP-Audio-Amplifier/Memoria/Parts/Index_Glossari.tex

\tableofcontents
\listoffigures
\listoftables

\chapter*{Glossari}
\addcontentsline{toc}{chapter}{\protect\numberline{}Glossari}
\begin{longtable}[H]{ll}
\textbf{I2S} & Inter-Integrated Circuit Sound
\\
\textbf{DSP} & Digital Signal Processing
\\
\textbf{FPGA} & Field-Programmable Gate Arrays
\\
\textbf{FET} & Field Effect Transistors
\\
\textbf{PWM} & Pulse Width Modulation
\\
\textbf{PDM} & Pulse Density Modulation
\\
\textbf{IC} & Integrated Circuit
\\
\textbf{VLSI} & Very Large Scale Integration
\\
\textbf{CLB} & Configurable Logic Blocks
\\
\textbf{SoC} & System on Chip
\\
\textbf{LUT} & Look Up Table
\\
\textbf{MAC} & Multiply and Accumulate
\\
\textbf{DSP} & Digital Signal Processing
\\
\textbf{CD} & Compact Disk
\\
\textbf{LSB} & Least Significant Bit
\\
\textbf{MSB} & Most Significant Bit
\\
\textbf{SCLK} & Serial Clock
\\
\textbf{BCLK} & Bit Clock
\\
\textbf{DSP} & Digital Signal Processing
\\
\textbf{WS} & Word Select
\\
\textbf{FIR} & Finite Impulse Response
\\
\textbf{CIC} & Cascaded Integrator-Comb
\\
\textbf{IIR} & Infinite Impulse Response
\\
\textbf{STF} & Signal Transfer Function
\\
\textbf{NTF} & Noise Transfer Function
\\
\textbf{CIFB} & Cascaded Integrator Feedback
\\
\textbf{CRFB} & Cascaded Resonator Feedback
\\
\textbf{CIFF} & Cascaded Integrator Feedforward
\\
\textbf{CRFF} & Cascaded Resonator Feedforward
\\
\textbf{SNR} & Signal to Noise Ratio
\\
\textbf{DR} & Dynamic Range
\\
\textbf{THD} & Total Harmonic Distorsion
\\
\textbf{FS} & Full Scale
\\
\textbf{SPI} & Serial Port Interface
\\
\textbf{RAM} & Random Access Memory
\\
\textbf{SD} & Secure Digital
\\
\textbf{RTOS} & Real Time Operating System
\\
\textbf{SIPO} & Serial-Input Parallel-Output
\\
\textbf{PIPO} & Parallel-Input Parallel-Output
\\
\textbf{VHDL} & Very High Speed Integrated Circuits Hardware Description Language
\\
\textbf{OSR} & Over-Sampling Ratio
\\
\textbf{EEBE} & Escola d'Enginyeria de Barcelona Est
\\
\textbf{SMI} & Salari Mínim Interprofessional
\\
\textbf{ECTS} & European Credit Transfer System
\end{longtable}
