Guimi22/DSP-Audio-Amplifier/Memoria/Parts/Portada.tex

\begin{titlepage}

\newcommand{\HRule}{\rule{\linewidth}{0.5mm}} % Defines a new command for the horizontal lines, change thickness here

% Logo
\centering
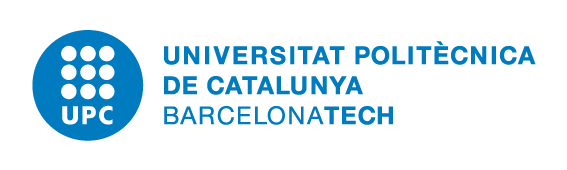
[picture p74: Memoria/upc-positiu-p3005.png]
\\[1cm] 
 
\center 

\textsc{\LARGE Treball Fi de Grau}\\[1.5cm] 
\textsc{\large \grau}\\[0.5cm] 
\textsc{\Large Memòria i Annexos}\\[0.5cm] 

% Title
\makeatletter
\HRule \\[0.4cm]
{ \huge \bfseries \titol}\\[0.4cm] % Title of your document
\HRule \\[1.5cm]
 
% Author

\begin{minipage}{0.4\textwidth}
\begin{flushleft} \large
\emph{Autor:}\\
\autortesi 

\end{flushleft}
\end{minipage}
~
\begin{minipage}{0.4\textwidth}
\begin{flushright} \large
\emph{Director:} \\
Prof. Jordi Cosp Vilella \\[1.2em] 
\end{flushright}
\end{minipage}\\[2cm]
\makeatother

% Date

{\large Convocatòria: Gener 2025}\\[2cm]

\begin{figure}[H]
\centering
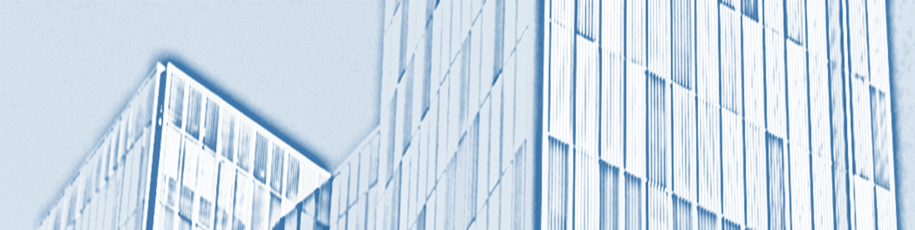
[picture p75: Memoria/logo_eebe_portada.png]
  
\end{figure}
\end{titlepage}

\vfill % Fill the rest of the page with whitespace
