Guimi22/DSP-Audio-Amplifier/Defensa/Imatges/void_setup.png

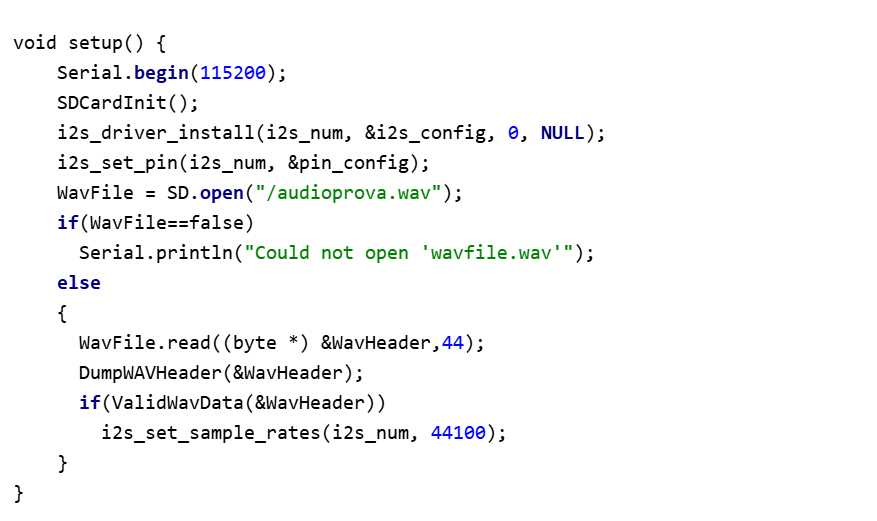
Defensa/Imatges/void_setup.png
