Guimi22/DSP-Audio-Amplifier/SW/VHDL/Draft/FIR_Filter/polyphase_FIR_v2.vhd

library IEEE;
use IEEE.std_logic_1164.all;
use IEEE.numeric_std.all;

entity polyphase_FIR is
	generic(size_ROM: integer := 91;
		size_pipeline_delay: integer := 45);
	port(	data_in: in std_logic_vector(15 downto 0);
		even_odd: in std_logic;
		clk: in std_logic;
		sclk_edge_flag: in std_logic;
		rst: in std_logic;
		audio_out: out signed(15 downto 0);
		audio_conv: out std_logic
		);
end polyphase_FIR;

architecture rtl of polyphase_FIR is

type array_signed is array (0 to size_ROM-1) of signed(15 downto 0);
type array_vector is array (0 to size_pipeline_delay) of std_logic_vector(15 downto 0);
signal products_array: array_signed;
signal multiplier: signed(31 downto 0);
signal accumulator: signed(31 downto 0);

signal ROM_coeff: array_signed;

CONSTANT coeff1                         : signed(15 DOWNTO 0) := to_signed(-3, 16); -- sfix16_En15
CONSTANT coeff2                         : signed(15 DOWNTO 0) := to_signed(4, 16); -- sfix16_En15
CONSTANT coeff3                         : signed(15 DOWNTO 0) := to_signed(-6, 16); -- sfix16_En15
CONSTANT coeff4                         : signed(15 DOWNTO 0) := to_signed(9, 16); -- sfix16_En15
CONSTANT coeff5                         : signed(15 DOWNTO 0) := to_signed(-13, 16); -- sfix16_En15
CONSTANT coeff6                         : signed(15 DOWNTO 0) := to_signed(18, 16); -- sfix16_En15
CONSTANT coeff7                         : signed(15 DOWNTO 0) := to_signed(-24, 16); -- sfix16_En15
CONSTANT coeff8                         : signed(15 DOWNTO 0) := to_signed(31, 16); -- sfix16_En15
CONSTANT coeff9                         : signed(15 DOWNTO 0) := to_signed(-39, 16); -- sfix16_En15
CONSTANT coeff10                        : signed(15 DOWNTO 0) := to_signed(48, 16); -- sfix16_En15
CONSTANT coeff11                        : signed(15 DOWNTO 0) := to_signed(-57, 16); -- sfix16_En15
CONSTANT coeff12                        : signed(15 DOWNTO 0) := to_signed(67, 16); -- sfix16_En15
CONSTANT coeff13                        : signed(15 DOWNTO 0) := to_signed(-77, 16); -- sfix16_En15
CONSTANT coeff14                        : signed(15 DOWNTO 0) := to_signed(87, 16); -- sfix16_En15
CONSTANT coeff15                        : signed(15 DOWNTO 0) := to_signed(-95, 16); -- sfix16_En15
CONSTANT coeff16                        : signed(15 DOWNTO 0) := to_signed(102, 16); -- sfix16_En15
CONSTANT coeff17                        : signed(15 DOWNTO 0) := to_signed(-107, 16); -- sfix16_En15
CONSTANT coeff18                        : signed(15 DOWNTO 0) := to_signed(108, 16); -- sfix16_En15
CONSTANT coeff19                        : signed(15 DOWNTO 0) := to_signed(-106, 16); -- sfix16_En15
CONSTANT coeff20                        : signed(15 DOWNTO 0) := to_signed(99, 16); -- sfix16_En15
CONSTANT coeff21                        : signed(15 DOWNTO 0) := to_signed(-87, 16); -- sfix16_En15
CONSTANT coeff22                        : signed(15 DOWNTO 0) := to_signed(69, 16); -- sfix16_En15
CONSTANT coeff23                        : signed(15 DOWNTO 0) := to_signed(-45, 16); -- sfix16_En15
CONSTANT coeff24                        : signed(15 DOWNTO 0) := to_signed(12, 16); -- sfix16_En15
CONSTANT coeff25                        : signed(15 DOWNTO 0) := to_signed(28, 16); -- sfix16_En15
CONSTANT coeff26                        : signed(15 DOWNTO 0) := to_signed(-76, 16); -- sfix16_En15
CONSTANT coeff27                        : signed(15 DOWNTO 0) := to_signed(132, 16); -- sfix16_En15
CONSTANT coeff28                        : signed(15 DOWNTO 0) := to_signed(-197, 16); -- sfix16_En15
CONSTANT coeff29                        : signed(15 DOWNTO 0) := to_signed(269, 16); -- sfix16_En15
CONSTANT coeff30                        : signed(15 DOWNTO 0) := to_signed(-349, 16); -- sfix16_En15
CONSTANT coeff31                        : signed(15 DOWNTO 0) := to_signed(435, 16); -- sfix16_En15
CONSTANT coeff32                        : signed(15 DOWNTO 0) := to_signed(-526, 16); -- sfix16_En15
CONSTANT coeff33                        : signed(15 DOWNTO 0) := to_signed(622, 16); -- sfix16_En15
CONSTANT coeff34                        : signed(15 DOWNTO 0) := to_signed(-721, 16); -- sfix16_En15
CONSTANT coeff35                        : signed(15 DOWNTO 0) := to_signed(821, 16); -- sfix16_En15
CONSTANT coeff36                        : signed(15 DOWNTO 0) := to_signed(-921, 16); -- sfix16_En15
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
    ROM_coeff(52) <= coeff53;
    ROM_coeff(53) <= coeff54;
    ROM_coeff(54) <= coeff55;
    ROM_coeff(55) <= coeff56;
    ROM_coeff(56) <= coeff57;
    ROM_coeff(57) <= coeff58;
    ROM_coeff(58) <= coeff59;
    ROM_coeff(59) <= coeff60;
    ROM_coeff(60) <= coeff61;
    ROM_coeff(61) <= coeff62;
    ROM_coeff(62) <= coeff63;
    ROM_coeff(63) <= coeff64;
    ROM_coeff(64) <= coeff65;
    ROM_coeff(65) <= coeff66;
    ROM_coeff(66) <= coeff67;
    ROM_coeff(67) <= coeff68;
    ROM_coeff(68) <= coeff69;
    ROM_coeff(69) <= coeff70;
    ROM_coeff(70) <= coeff71;
    ROM_coeff(71) <= coeff72;
    ROM_coeff(72) <= coeff73;
    ROM_coeff(73) <= coeff74;
    ROM_coeff(74) <= coeff75;
    ROM_coeff(75) <= coeff76;
    ROM_coeff(76) <= coeff77;
    ROM_coeff(77) <= coeff78;
    ROM_coeff(78) <= coeff79;
    ROM_coeff(79) <= coeff80;
    ROM_coeff(80) <= coeff81;
    ROM_coeff(81) <= coeff82;
    ROM_coeff(82) <= coeff83;
    ROM_coeff(83) <= coeff84;
    ROM_coeff(84) <= coeff85;
    ROM_coeff(85) <= coeff86;
    ROM_coeff(86) <= coeff87;
    ROM_coeff(87) <= coeff88;
    ROM_coeff(88) <= coeff89;
    ROM_coeff(89) <= coeff90;
    ROM_coeff(90) <= coeff91;


	Delay_Pipeline_process : process (clk)
		begin
			if clk'event and clk = '1' then
				if rst = '1' then
					delay_pipeline(0 to size_pipeline_delay) <= (others => (others => '0'));
				elsif sclk_edge_flag = '1' then
					delay_pipeline(1 to size_pipeline_delay) <= delay_pipeline(0 to size_pipeline_delay-1);
					delay_pipeline(0) <= data_in;
				end if;
			end if;
		end process Delay_Pipeline_process;
	
	
	-- MAC convolution
	Convolution_trigger: process(clk)
		begin
			if clk'event and clk = '1' then
				if rst = '1' then
					conv_trig <= '0';
				elsif sclk_edge_flag = '1' then
					conv_trig <= '1';
					audio_filtered <= '0';
				elsif index = size_ROM - 1 or index = size_ROM then
					conv_trig <= '0';
					audio_filtered <= '1';
				end if;
			end if;
		end process;
		
	audio_conv <= audio_filtered;

	Index_control: process(clk)
		begin
			if clk'event and clk = '1' then
				if rst = '1' then
					index <= 0;
					index_pipeline <= 0;
				elsif index = size_ROM - 1 or index = size_ROM or index_pipeline = size_pipeline_delay then
					index <= 0;
					index_pipeline <= 0;
				elsif conv_trig = '1' then
					if even_odd = '0' then
						index <= index + 2;
					elsif even_odd = '1' then
						if index = 0 then
							index <= 1;
						else
							index <= index + 2;
						end if;
					end if;
					index_pipeline <= index_pipeline + 1;
				end if;
			end if;
		end process;
	
	MAC_process: process(clk)
		begin
			if clk'event and clk = '1' then
				if rst = '1' then
					accumulator <= to_signed(0,32);
					multiplier <= to_signed(0,32);
				elsif conv_trig = '1' then
					multiplier <= ROM_coeff(index) * signed(delay_pipeline(index_pipeline));
					accumulator <= accumulator + multiplier;
				end if;
			end if;
		end process;
	
--	for_products: for i in 0 to size_ROM-1 generate
--		products_array(i) <= resize(ROM_coeff(i) * signed(delay_pipeline(i)), 16) when (even_odd = '0') and (i mod 2 = 0) 
--		else resize(ROM_coeff((size_ROM - 1) - i) * signed(delay_pipeline(i)), 16) when (even_odd /= '0') and (i mod 2 /= 0) 
--		else to_signed(0, 16);
--	end generate for_products;
--		
--	for_adders: for i in 0 to size_ROM-1 generate
--		adder_convolution <= resize(adder_convolution + products_array(i),16);
--	end generate for_adders;
	
	audio_out <= resize(accumulator,16);

end rtl;
